OLIMEX/OLIMEXINO-2560/README.md

# OLIMEXINO-2560
Arduino Mega 2560 like board with ATMEGA2560 processor, 88 GPIOs, uSD card, 6-15VDC power

## License
* Software Licensee is GPL 3.0
* Hardware Licensee is CERN Open Hardware Licence v1.2
* Documentation is released under CC BY-SA 3.0
