OLIMEX/OLIMEXINO-2560/HARDWARE/OLIMEXINO-2560_Rev_A2_BOM.ods

Designation | Quantity | Designator | Package
SMD КЛЮЧ БУТОН TSW34-W16PR-220 / SIDE W | 1 | BUTTON1 | TSW34-W16PR-220
SMD КОНД 0402 100 NF 10% 10VDC | 7 | C1,C15,C17,C18,C19,C20,C21 | C_0402_5MIL_DWS
SMD КОНД 0402 10 NF X7R 50VDC | 1 | C10 | C_0603_5MIL_DWS
SMD КОНД 0402 12 PF NP0 5% | 2 | C11,C14 | C_0402_SMALL
SMD КОНД 0402 33 PF +-0.25 PF | 2 | C12,C13 | 402
SMD КОНД 0603 22 UF 6.3V | 6 | C2,C4,C5,C7,C8,C16 | C_0603_5MIL_DWS
SMD КОНД 1206 22 UF 25VDC X7R | 1 | C3 | C_1206_5MIL_DWS
(na)100nF | 1 | C6 | C_0402_5MIL_DWS
(na)2.2uF | 1 | C9 | C_0603_5MIL_DWS
SMBJ16A | 1 | D2 | SMB-KA
FB0805 | 3 | FB1,FB2,FB3 | L_0805_5MIL_DWS
IRML6402 | 2 | FET1,FET2 | SOT23
РЕЙКА 1 X 40 (HN 1X40) | 2 X 3/40 | J1, J2 | HN1x3
SMD ИНДУКТИВНОСТ CD43 4.7 UH | 1 | L1 | CD43
YELLOW | 1 | LED1 | LED_0603_KA_NOSILK
GREEN | 2 | LED2,LED4 | LED_0603_KA_NOSILK
RED | 2 | LED3,LED5 | LED_0603_KA_NOSILK
MICRO_SD(TFC-WXCP11-08-LF) | 1 | MICRO_SD1 | TFC-WXCP11-08-LF
СЪЕДИНИТЕЛ PWR-JACK (DC-004) | 1 | PWR1 | IDJ-1174.1
SMD РЕЗ. 5x3.2mm 16 Mhz 30PPM 12PF | 1 | Q1 | HCX-4S_2Pins_5.0x3.2mm
SMD РЕЗ 0402 330 OHM 5% | 1 | R15 | R_0402_5MIL_DWS
SMD РЕЗ 0402 1 K 5% | 3 | R16,R19,R21 | R_0402_5MIL_DWS
SMD РЕЗ 0402 2 K 5% | 5 | R1,R3,R6,R17,R18 | R_0402_5MIL_DWS
SMD РЕЗ 0603 49.9 K 1% | 1 | R4 | R_0603_5MIL_DWS
SMD РЕЗ 0402 10 K 5% | 10 | R2,R5,R8,R9,R10,R11,R12,R13,R14,R20 | R_0402_5MIL_DWS
SMD РЕЗ 0402 6.81 K 1% | 1 | R7 | R_0402_5MIL_DWS
SMD ИС SY8120B1 4.5-18V 2A | 1 | U1 | SOT23-6
SMD ИС CH340T SSOP20 | 1 | U2 | SSOP-20W
SMD ИС MCP1700T-3302E/MB | 1 | U3 | SOT89
SMD ИС ATMEGA2560-16AU | 1 | U4 | TQFP100
SMD ДИОД BAT54TW | 1 | U5 | SOT363
СЪЕДИНИТЕЛ BH10R 2x5 ЪГЪЛ | 1 | UEXT1 | UEXT_BH10R
SMD СЪЕДИНИТЕЛ MISB-SWMM-5B-LF /USB-MICRO/ | 1 | USB1 | USB-MICRO-5P-F
SMD РЕЗОНАТОР КВАРЦ - 12 MHZ 30ppm 20pf | 1 | X1 | Q_49U3HMS
СЪЕДИНИТЕЛ FE-D13A-1X06-LF(H=11.04mm) | 1
СЪЕДИНИТЕЛ FE-D13A-1X08-LF(H=11.04mm) | 3
Променени са стойностите на: R9,R10, R20, C11, C12
