OLIMEX/OLIMEXINO-2560/HARDWARE/3d/CD32_inductor.step

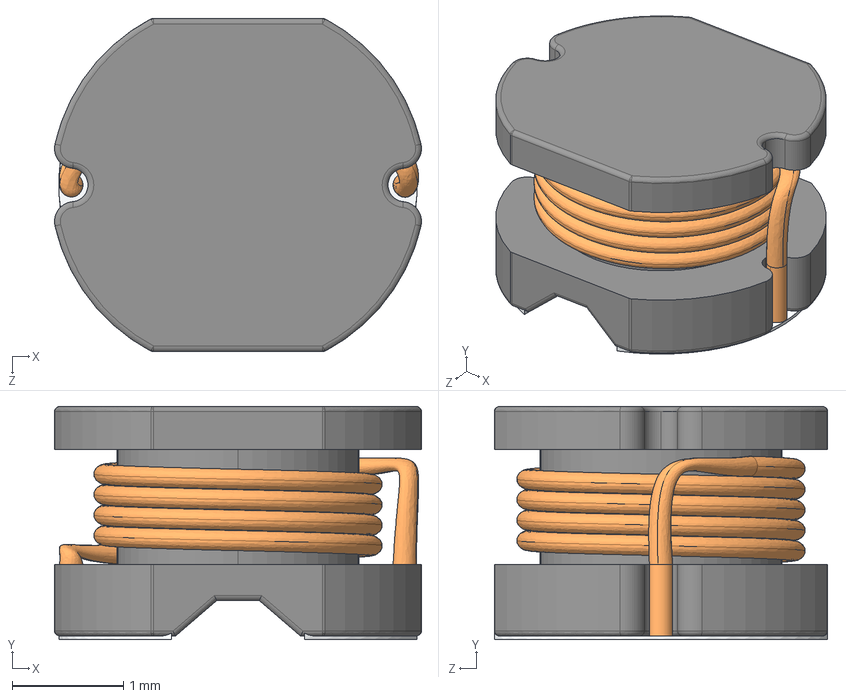
[picture p1: CAD file, 2019-06-20]
HARDWARE/3d/CD32_inductor.step
3.30 x 2.10 x 3.00 mm
