OLIMEX/OLIMEXINO-2560/HARDWARE/3d/usb_micro_4p.stp

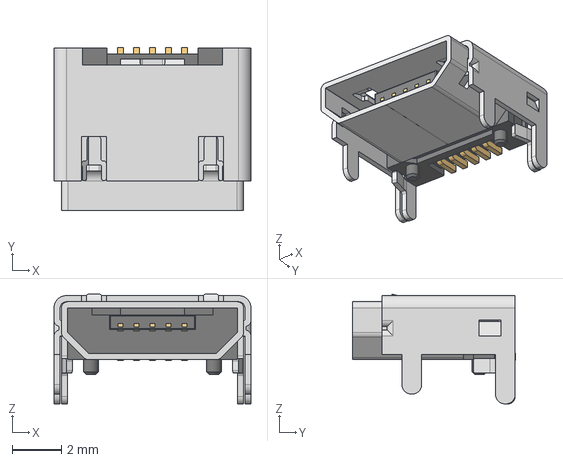
[picture p2: CAD file, 2019-06-20]
HARDWARE/3d/usb_micro_4p.stp
8.00 x 6.60 x 4.46 mm
