OLIMEX/OLIMEXINO-2560/HARDWARE/3d/SOT-23.step

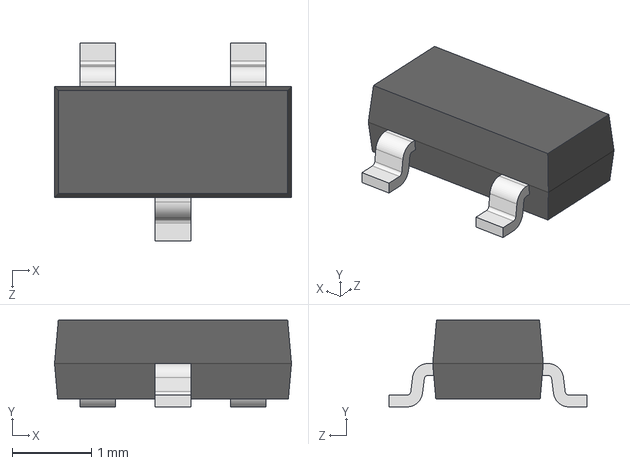
[picture p3: CAD file, 2019-06-20]
HARDWARE/3d/SOT-23.step
3.00 x 1.10 x 2.50 mm
