OLIMEX/OLIMEXINO-2560/HARDWARE/3d/Header_right_angle_10way(2x5).step

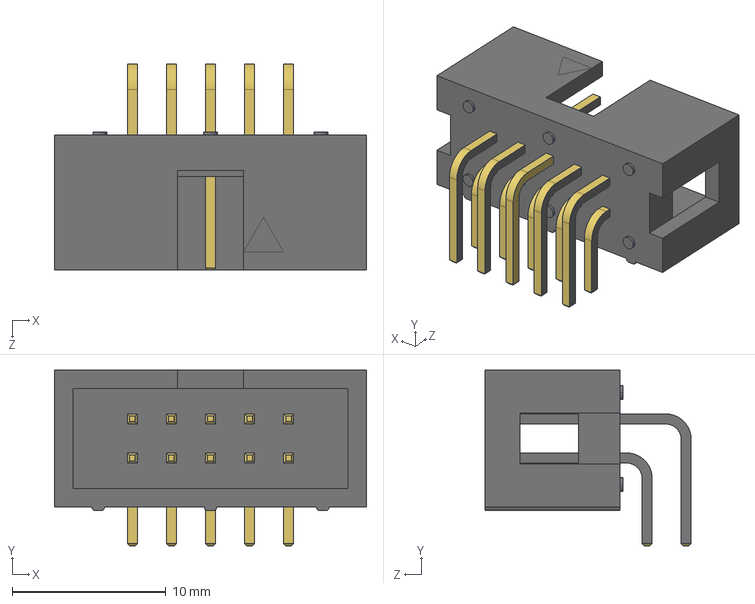
[picture p4: CAD file, 2019-06-20]
HARDWARE/3d/Header_right_angle_10way(2x5).step
20.3 x 11.4 x 13.4 mm
