OLIMEX/OLIMEXINO-2560/HARDWARE/3d/SOT-23-6.step

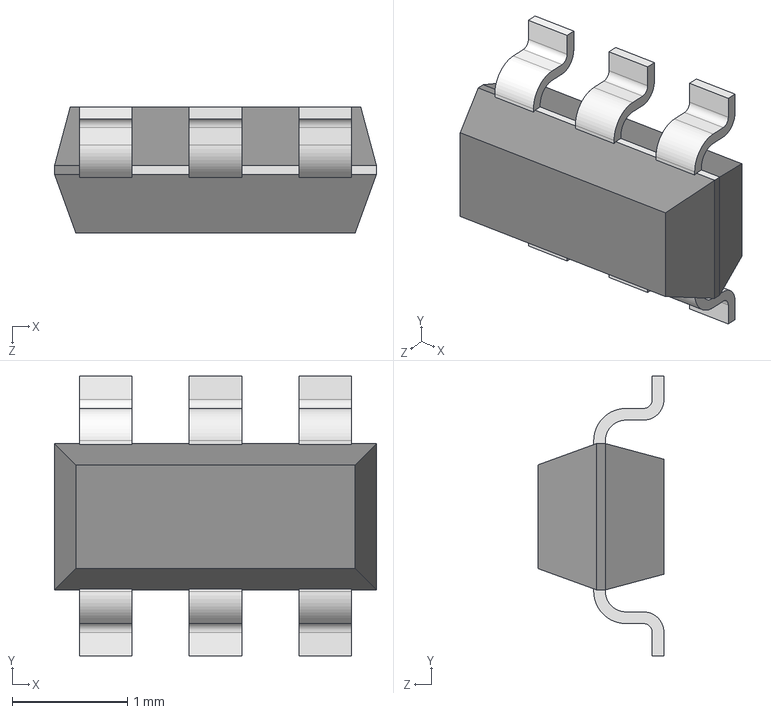
[picture p5: CAD file, 2019-06-20]
HARDWARE/3d/SOT-23-6.step
2.79 x 2.43 x 1.09 mm
