OLIMEX/OLIMEXINO-2560/HARDWARE/3d/Header _Fem_1X8.step

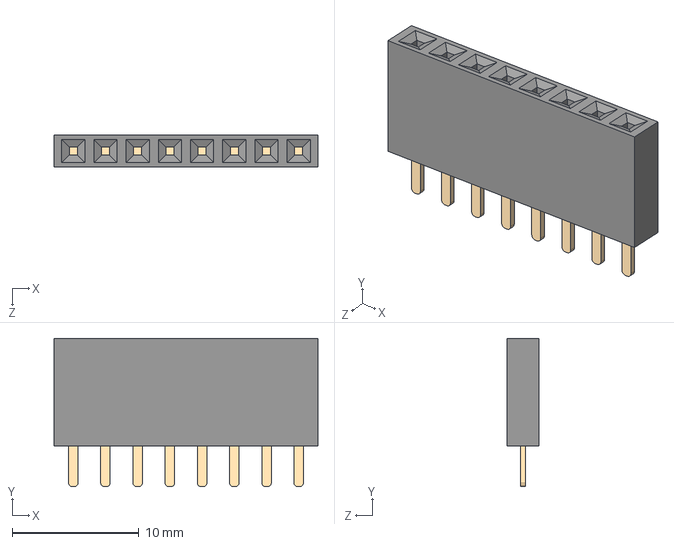
[picture p6: CAD file, 2019-06-20]
HARDWARE/3d/Header _Fem_1X8.step
20.8 x 11.7 x 2.54 mm
