OLIMEX/OLIMEXINO-2560/HARDWARE/3d/DO-214AA_SMB.step

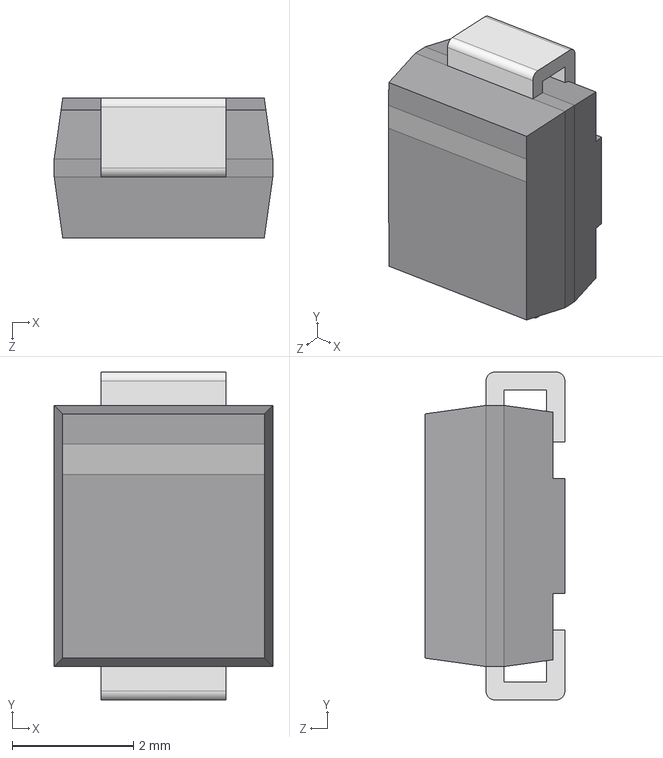
[picture p7: CAD file, 2019-06-20]
HARDWARE/3d/DO-214AA_SMB.step
3.60 x 5.40 x 2.30 mm
