OLIMEX/OLIMEXINO-2560/HARDWARE/3d/Header_Fem_1X6.step

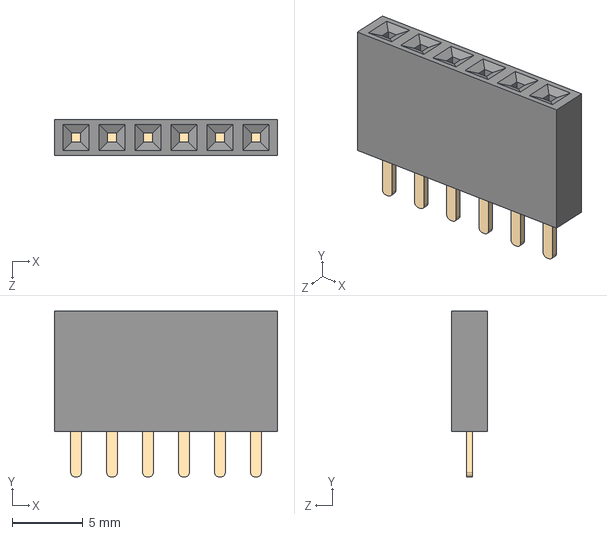
[picture p8: CAD file, 2019-06-20]
HARDWARE/3d/Header_Fem_1X6.step
15.7 x 11.7 x 2.54 mm
