OLIMEX/OLIMEXINO-2560/HARDWARE/3d/Header_Fem_1X4.step

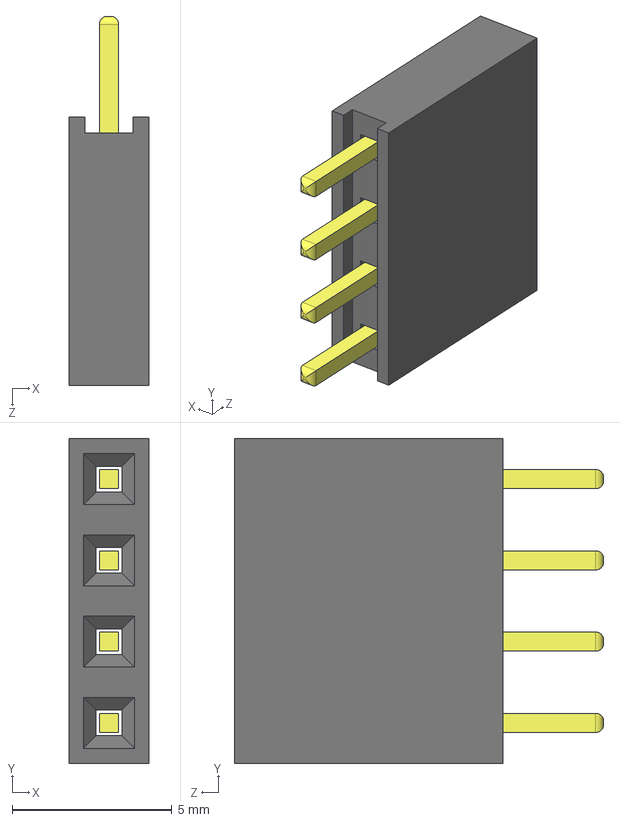
[picture p9: CAD file, 2019-06-20]
HARDWARE/3d/Header_Fem_1X4.step
2.50 x 10.2 x 11.6 mm
