OLIMEX/OLIMEXINO-2560/HARDWARE/3d/HN1x3.step

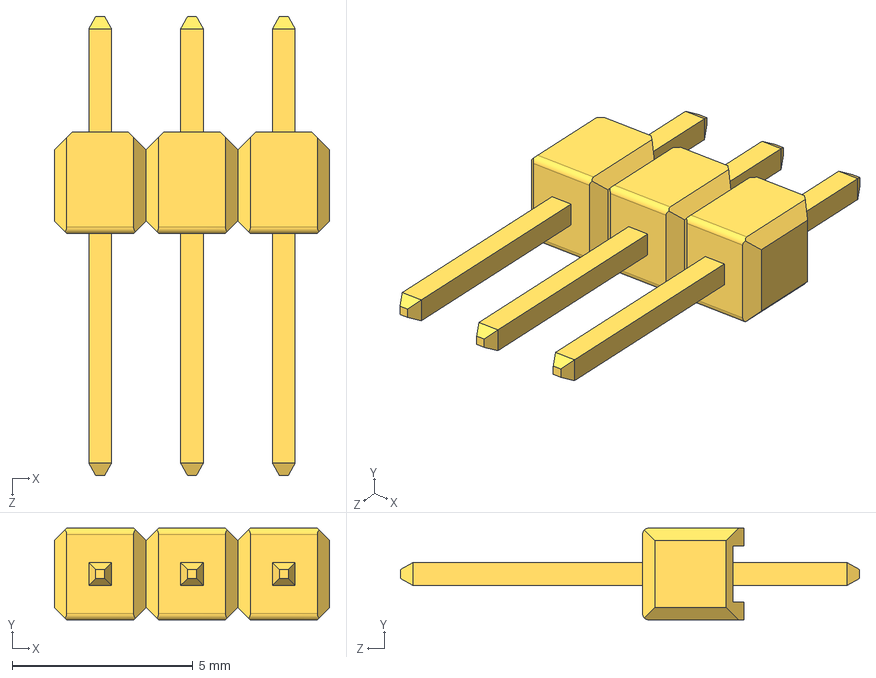
[picture p10: CAD file, 2019-06-20]
HARDWARE/3d/HN1x3.step
7.62 x 2.54 x 12.7 mm
