OLIMEX/OLIMEXINO-2560/HARDWARE/3d/tactile_sidesw.stp

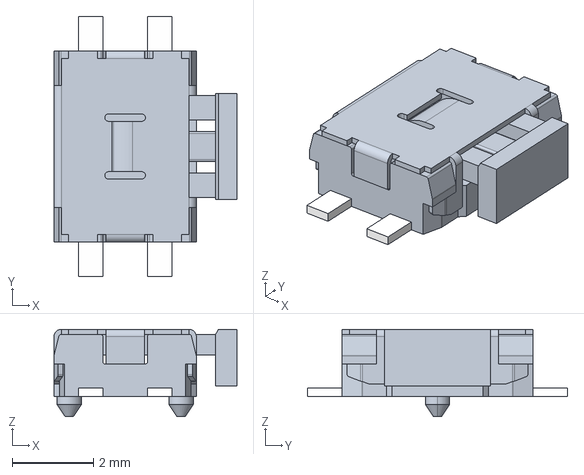
[picture p11: CAD file, 2019-06-20]
HARDWARE/3d/tactile_sidesw.stp
4.50 x 6.40 x 2.15 mm
