OLIMEX/OLIMEXINO-2560/HARDWARE/3d/User_Library-Crystal_HC49_US-SM.step

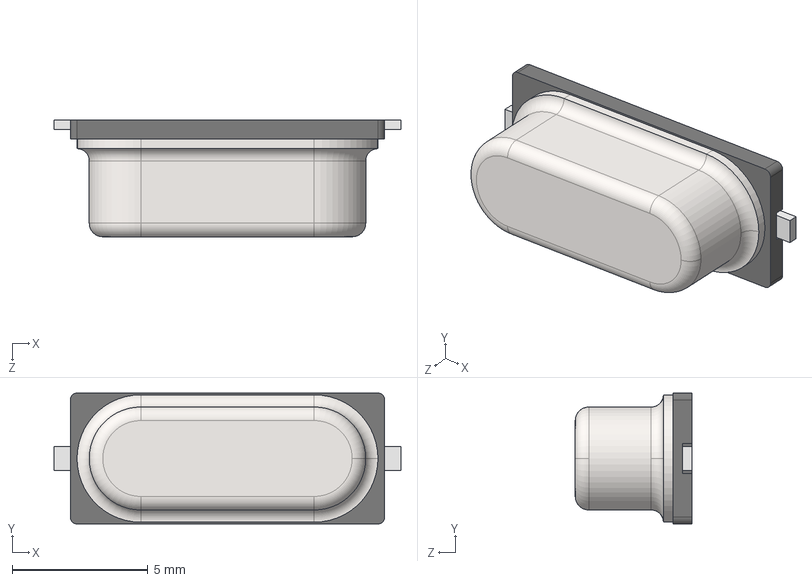
[picture p12: CAD file, 2019-06-20]
HARDWARE/3d/User_Library-Crystal_HC49_US-SM.step
12.8 x 4.83 x 4.30 mm
