OLIMEX/OLIMEXINO-2560/HARDWARE/3d/JUMPER.step

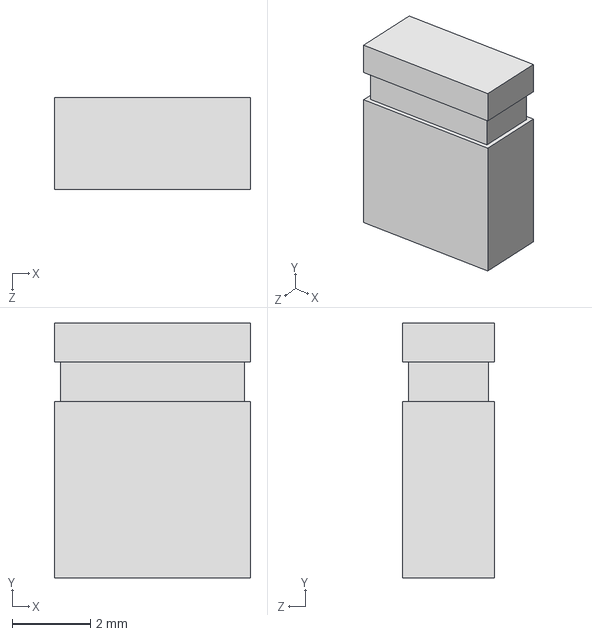
[picture p13: CAD file, 2019-06-20]
HARDWARE/3d/JUMPER.step
5.00 x 6.50 x 2.35 mm
