OLIMEX/OLIMEXINO-2560/HARDWARE/3d/SOT-89.step

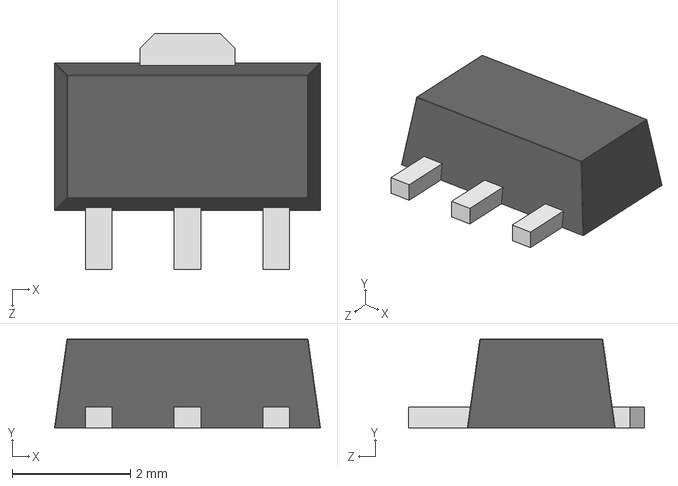
[picture p14: CAD file, 2019-06-20]
HARDWARE/3d/SOT-89.step
4.50 x 1.50 x 4.00 mm
