OLIMEX/OLIMEXINO-2560/HARDWARE/3d/pj-003a.stp

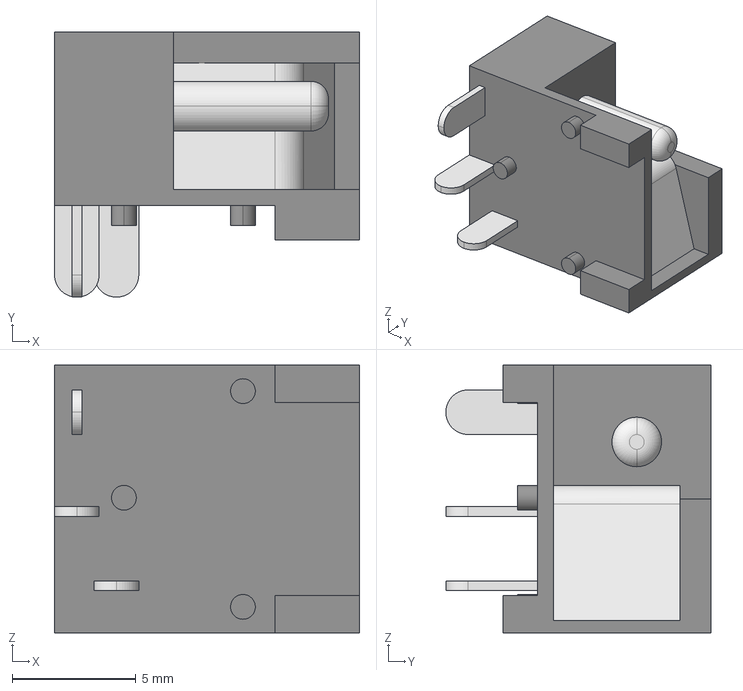
[picture p15: CAD file, 2019-06-20]
HARDWARE/3d/pj-003a.stp
12.3 x 10.7 x 10.8 mm
