OLIMEX/OLIMEXINO-2560/HARDWARE/3d/SMD5032.STEP

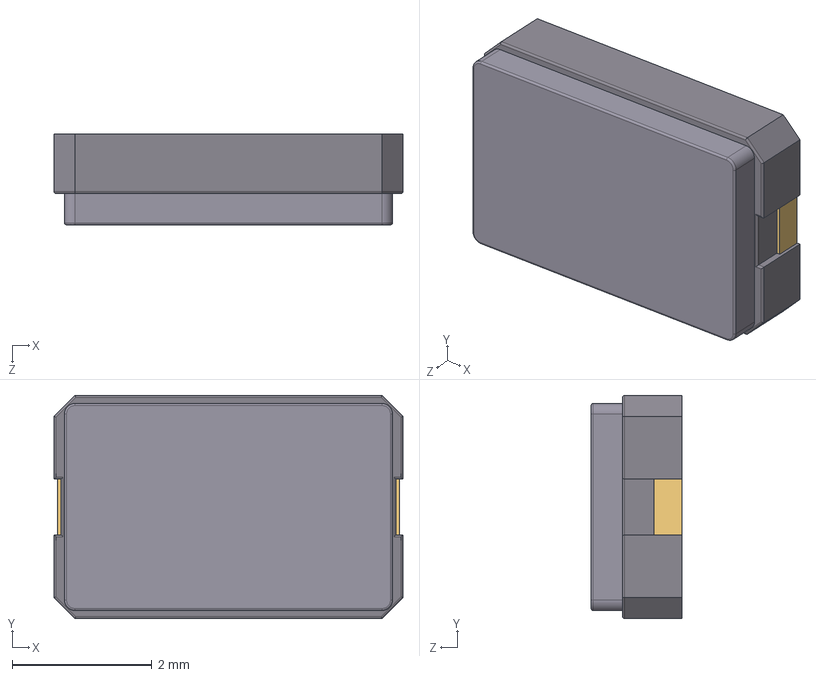
[picture p16: CAD file, 2019-06-20]
HARDWARE/3d/SMD5032.STEP
5.00 x 3.20 x 1.30 mm
User Library-ABM3-1_Fillet002
User Library-ABM3-1_Fillet001
User Library-ABM3-1_Pad001
