OLIMEX/OLIMEXINO-2560/HARDWARE/3d/693063020911.stp

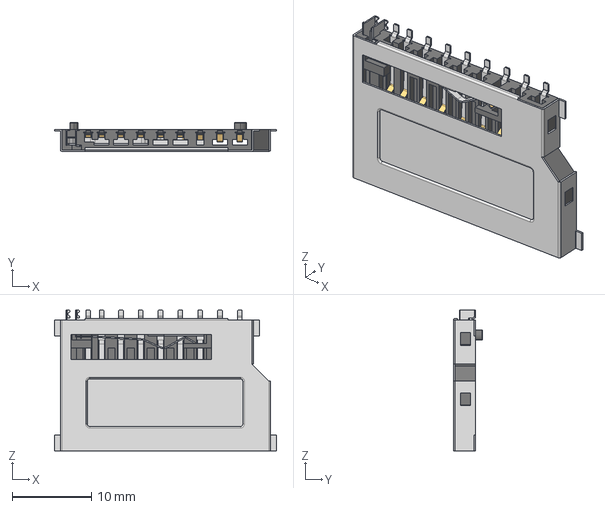
[picture p17: CAD file, 2019-06-20]
HARDWARE/3d/693063020911.stp
28.0 x 3.65 x 17.8 mm
