OLIMEX/OLIMEXINO-2560/HARDWARE/OLIMEXINO-2560_Rev_B.pdf

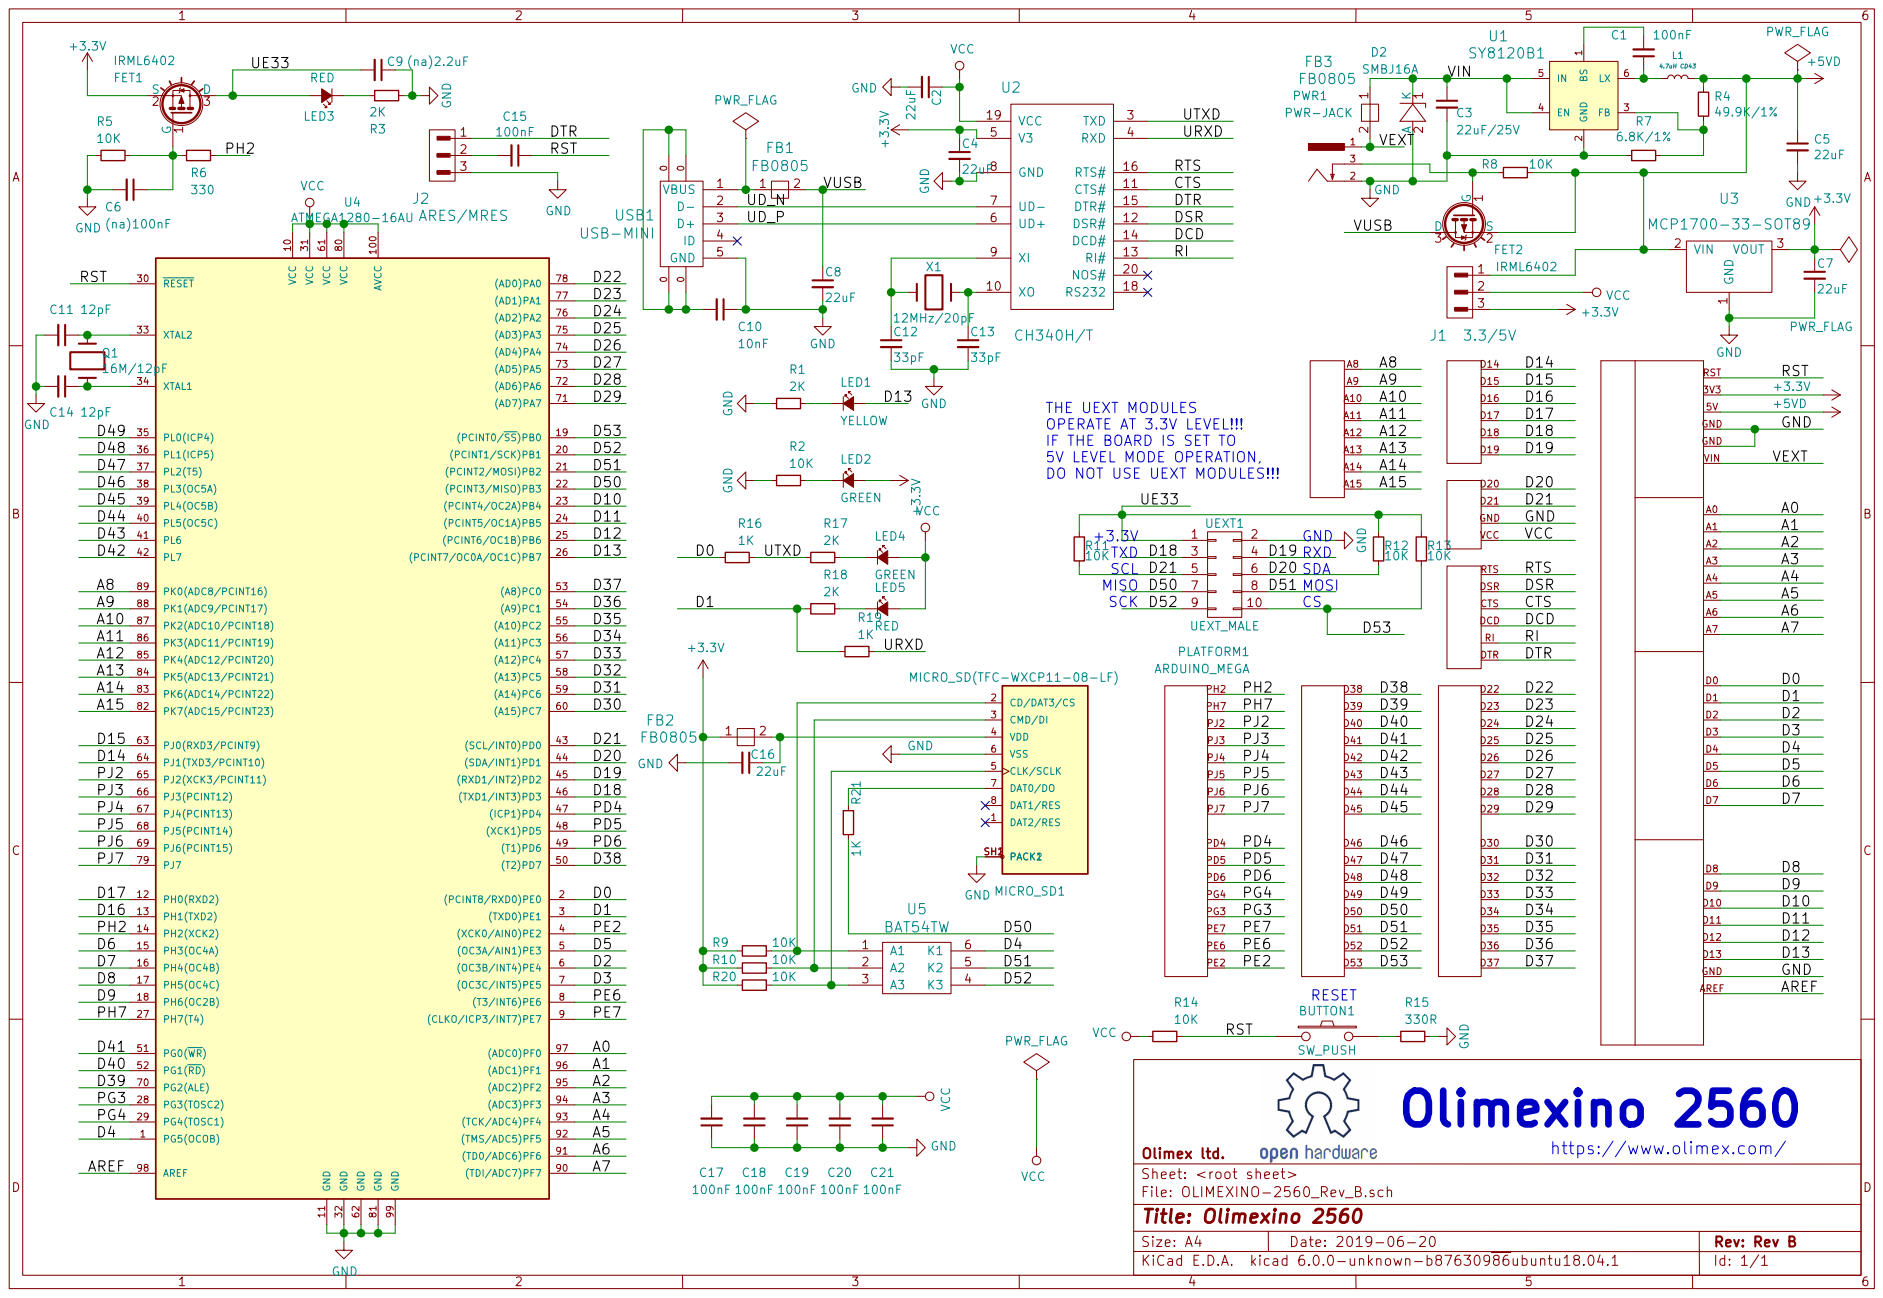
[picture p20: page 1]

OPERATE AT 3.3V LEVEL!!!
IF THE BOARD IS SET TO
5V LEVEL MODE OPERATION,

DO NOT USE UEXT MODULES!!! C17

File: OLIMEXINO-2560_Rev_B.sch Sheet: <root sheet> Olimex ltd.

https://www.olimex.com/
