OLIMEX/OLIMEXINO-2560/HARDWARE/OLIMEXINO-2560_Rev_B.kicad_pcb

## KiCad design HARDWARE/OLIMEXINO-2560_Rev_B.kicad_pcb (2019-06-20)

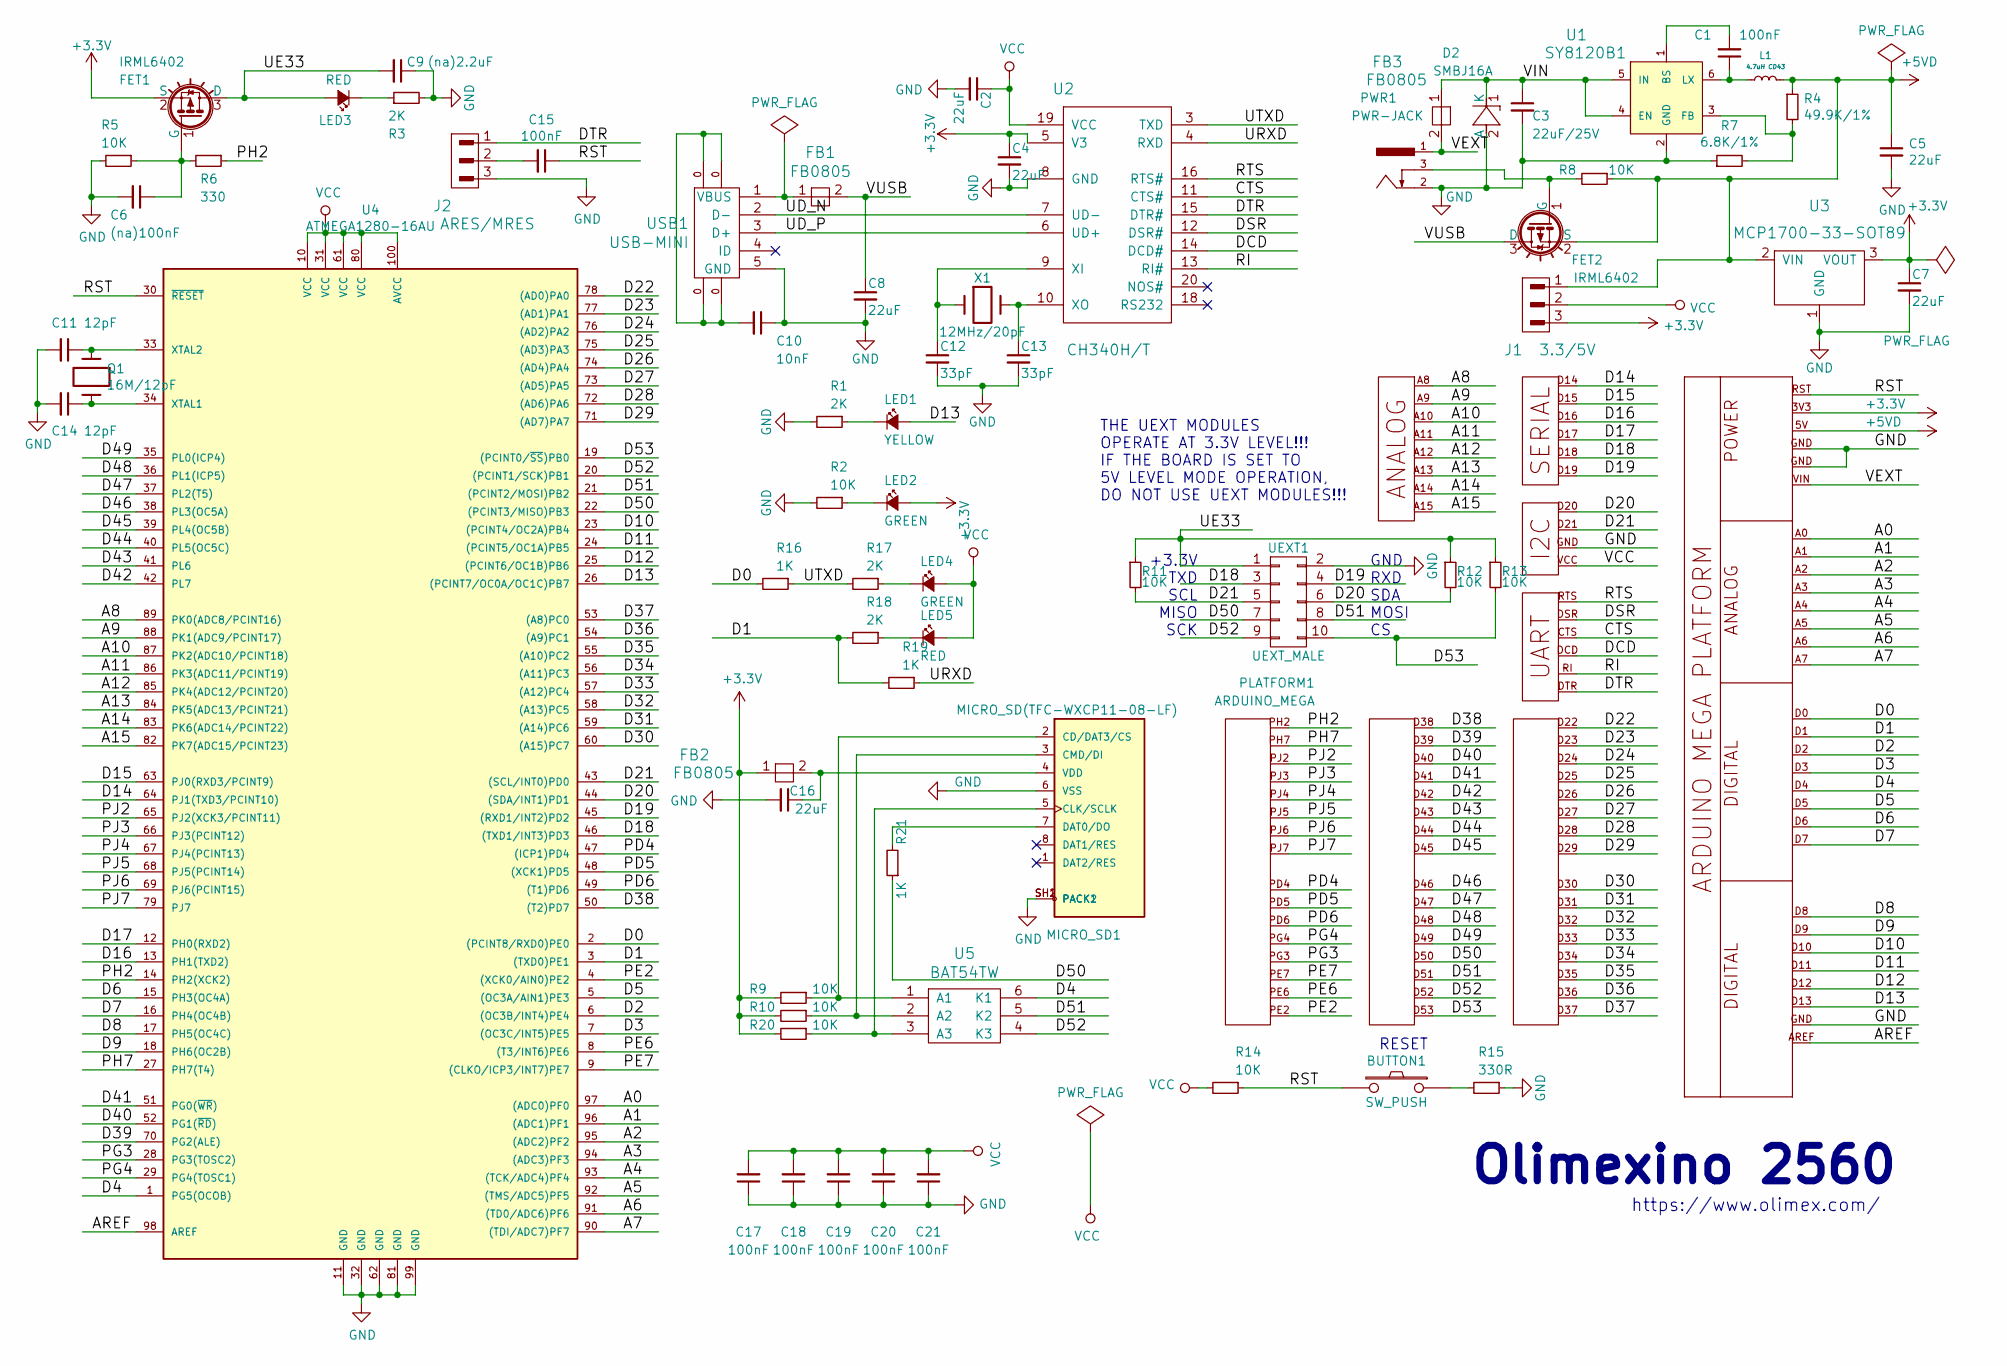
[picture p21: schematic OLIMEXINO-2560_Rev_B.sch, Olimexino 2560]

Parts:
BUTTON1: SW_PUSH; TSW34-W16PR-220
C1, C15, C17, C18, C19, C20, C21: 100nF; C_0402_5MIL_DWS
C2, C4, C5, C7, C8, C16: 22uF; C_0603_5MIL_DWS
C3: 22uF/25V; C_1206_5MIL_DWS
C6: (na)100nF; C_0402_5MIL_DWS
C9: (na)2.2uF; C_0603_5MIL_DWS
C10: 10nF; C_0603_5MIL_DWS
C11, C14: 12pF; C_0402_SMALL
C12, C13: 33pF; 0402
D2: SMBJ16A; SMB-KA
FB1, FB2, FB3: FB0805; L_0805_5MIL_DWS
FET1, FET2: IRML6402; SOT23
J1: 3.3/5V; HN1x3
J2: ARES/MRES; HN1x3
L1: 4.7uH CD43; CD43
LED1: YELLOW; LED_0603_KA_NOSILK
LED2, LED4: GREEN; LED_0603_KA_NOSILK
LED3, LED5: RED; LED_0603_KA_NOSILK
MICRO_SD1: MICRO_SD(TFC-WXCP11-08-LF); TFC-WXCP11-08-LF
PLATFORM1: ARDUINO_MEGA; OLIMEX_CASES-ARDUINO-MEGA-PLATFORM
PWR1: PWR-JACK; PWRJACK-FLAT
Q1: 16M/12pF; HCX-4S_2Pins_5.0x3.2mm
R1, R3, R17, R18: 2K; R_0402_5MIL_DWS
R2, R5, R8, R9, R10, R11, R12, R13, R14, R20: 10K; R_0402_5MIL_DWS
R4: 49.9K/1%; R_0603_5MIL_DWS
R6: 330; R_0402_5MIL_DWS
R7: 6.8K/1%; R_0402_5MIL_DWS
R15: 330R; R_0402_5MIL_DWS
R16, R19, R21: 1K; R_0402_5MIL_DWS
U1: SY8120B1; SOT23-6
U2: CH340H/T; SSOP-20W
U3: MCP1700-33-SOT89; SOT89
U4: ATMEGA1280-16AU; TQFP100
U5: BAT54TW; SOT363
UEXT1: UEXT_MALE; UEXT_BH10R
USB1: USB-MINI; MICRO_USB_5P-F_TYPE_DIP
X1: 12MHz/20pF; Q_49U3HMS

Connections:
+3V3: C4.1, C7.1, FB2.1, FET1.2 (S), J1.3, LED2.2 (A), PLATFORM1.3V3, R9.2, R10.2, R20.2, U2.5 (V3), U3.3 (VOUT)
+5VD: C5.1, FET2.2 (S), J1.1, L1.2, PLATFORM1.5V, R4.1, R8.1, U3.2 (VIN)
/A0: PLATFORM1.A0, U4.97 ((ADC0)PF0)
/A1: PLATFORM1.A1, U4.96 ((ADC1)PF1)
/A2: PLATFORM1.A2, U4.95 ((ADC2)PF2)
/A3: PLATFORM1.A3, U4.94 ((ADC3)PF3)
/A4: PLATFORM1.A4, U4.93 ((TCK/ADC4)PF4)
/A5: PLATFORM1.A5, U4.92 ((TMS/ADC5)PF5)
/A6: PLATFORM1.A6, U4.91 ((TD0/ADC6)PF6)
/A7: PLATFORM1.A7, U4.90 ((TDI/ADC7)PF7)
/A8: PLATFORM1.A8, U4.89 (PK0(ADC8/PCINT16))
/A9: PLATFORM1.A9, U4.88 (PK1(ADC9/PCINT17))
/A10: PLATFORM1.A10, U4.87 (PK2(ADC10/PCINT18))
/A11: PLATFORM1.A11, U4.86 (PK3(ADC11/PCINT19))
/A12: PLATFORM1.A12, U4.85 (PK4(ADC12/PCINT20))
/A13: PLATFORM1.A13, U4.84 (PK5(ADC13/PCINT21))
/A14: PLATFORM1.A14, U4.83 (PK6(ADC14/PCINT22))
/A15: PLATFORM1.A15, U4.82 (PK7(ADC15/PCINT23))
/AREF: PLATFORM1.AREF, U4.98 (AREF)
/CTS: PLATFORM1.CTS, U2.11 (CTS#)
/D0: PLATFORM1.D0, R16.2, U4.2 ((PCINT8/RXD0)PE0)
/D1: PLATFORM1.D1, R18.2, R19.2, U4.3 ((TXD0)PE1)
/D2: PLATFORM1.D2, U4.6 ((OC3B/INT4)PE4)
/D3: PLATFORM1.D3, U4.7 ((OC3C/INT5)PE5)
/D4: PLATFORM1.D4, U4.1 (PG5(OCOB)), U5.6 (K1)
/D5: PLATFORM1.D5, U4.5 ((OC3A/AIN1)PE3)
/D6: PLATFORM1.D6, U4.15 (PH3(OC4A))
/D7: PLATFORM1.D7, U4.16 (PH4(OC4B))
/D8: PLATFORM1.D8, U4.17 (PH5(OC4C))
/D9: PLATFORM1.D9, U4.18 (PH6(OC2B))
/D10: PLATFORM1.D10, U4.23 ((PCINT4/OC2A)PB4)
/D11: PLATFORM1.D11, U4.24 ((PCINT5/OC1A)PB5)
/D12: PLATFORM1.D12, U4.25 ((PCINT6/OC1B)PB6)
/D13: LED1.2 (A), PLATFORM1.D13, U4.26 ((PCINT7/OC0A/OC1C)PB7)
/D14: PLATFORM1.D14, U4.64 (PJ1(TXD3/PCINT10))
/D15: PLATFORM1.D15, U4.63 (PJ0(RXD3/PCINT9))
/D16: PLATFORM1.D16, U4.13 (PH1(TXD2))
/D17: PLATFORM1.D17, U4.12 (PH0(RXD2))
/D18: PLATFORM1.D18, U4.46 ((TXD1/INT3)PD3), UEXT1.3
/D19: PLATFORM1.D19, U4.45 ((RXD1/INT2)PD2), UEXT1.4
/D20: PLATFORM1.D20, R12.2, U4.44 ((SDA/INT1)PD1), UEXT1.6
/D21: PLATFORM1.D21, R11.2, U4.43 ((SCL/INT0)PD0), UEXT1.5
/D22: PLATFORM1.D22, U4.78 ((AD0)PA0)
/D23: PLATFORM1.D23, U4.77 ((AD1)PA1)
/D24: PLATFORM1.D24, U4.76 ((AD2)PA2)
/D25: PLATFORM1.D25, U4.75 ((AD3)PA3)
/D26: PLATFORM1.D26, U4.74 ((AD4)PA4)
/D27: PLATFORM1.D27, U4.73 ((AD5)PA5)
/D28: PLATFORM1.D28, U4.72 ((AD6)PA6)
/D29: PLATFORM1.D29, U4.71 ((AD7)PA7)
/D30: PLATFORM1.D30, U4.60 ((A15)PC7)
/D31: PLATFORM1.D31, U4.59 ((A14)PC6)
/D32: PLATFORM1.D32, U4.58 ((A13)PC5)
/D33: PLATFORM1.D33, U4.57 ((A12)PC4)
/D34: PLATFORM1.D34, U4.56 ((A11)PC3)
/D35: PLATFORM1.D35, U4.55 ((A10)PC2)
/D36: PLATFORM1.D36, U4.54 ((A9)PC1)
/D37: PLATFORM1.D37, U4.53 ((A8)PC0)
/D38: PLATFORM1.D38, U4.50 ((T2)PD7)
/D39: PLATFORM1.D39, U4.70 (PG2(ALE))
/D40: PLATFORM1.D40, U4.52 (PG1(~RD~))
/D41: PLATFORM1.D41, U4.51 (PG0(~WR~))
/D42: PLATFORM1.D42, U4.42 (PL7)
/D43: PLATFORM1.D43, U4.41 (PL6)
/D44: PLATFORM1.D44, U4.40 (PL5(OC5C))
/D45: PLATFORM1.D45, U4.39 (PL4(OC5B))
/D46: PLATFORM1.D46, U4.38 (PL3(OC5A))
/D47: PLATFORM1.D47, U4.37 (PL2(T5))
/D48: PLATFORM1.D48, U4.36 (PL1(ICP5))
/D49: PLATFORM1.D49, U4.35 (PL0(ICP4))
/D50: PLATFORM1.D50, R21.1, U4.22 ((PCINT3/MISO)PB3), UEXT1.7
/D51: PLATFORM1.D51, U4.21 ((PCINT2/MOSI)PB2), U5.5 (K2), UEXT1.8
/D52: PLATFORM1.D52, U4.20 ((PCINT1/SCK)PB1), U5.4 (K3), UEXT1.9
/D53: PLATFORM1.D53, R13.2, U4.19 ((PCINT0/~SS~)PB0), UEXT1.10
/DCD: PLATFORM1.DCD, U2.14 (DCD#)
/DSR: PLATFORM1.DSR, U2.12 (DSR#)
/DTR: J2.1, PLATFORM1.DTR, U2.15 (DTR#)
/PD4: PLATFORM1.PD4, U4.47 ((ICP1)PD4)
/PD5: PLATFORM1.PD5, U4.48 ((XCK1)PD5)
/PD6: PLATFORM1.PD6, U4.49 ((T1)PD6)
/PE2: PLATFORM1.PE2, U4.4 ((XCK0/AIN0)PE2)
/PE6: PLATFORM1.PE6, U4.8 ((T3/INT6)PE6)
/PE7: PLATFORM1.PE7, U4.9 ((CLKO/ICP3/INT7)PE7)
/PG3: PLATFORM1.PG3, U4.28 (PG3(TOSC2))
/PG4: PLATFORM1.PG4, U4.29 (PG4(TOSC1))
/PH2: PLATFORM1.PH2, R6.1, U4.14 (PH2(XCK2))
/PH7: PLATFORM1.PH7, U4.27 (PH7(T4))
/PJ2: PLATFORM1.PJ2, U4.65 (PJ2(XCK3/PCINT11))
/PJ3: PLATFORM1.PJ3, U4.66 (PJ3(PCINT12))
/PJ4: PLATFORM1.PJ4, U4.67 (PJ4(PCINT13))
/PJ5: PLATFORM1.PJ5, U4.68 (PJ5(PCINT14))
/PJ6: PLATFORM1.PJ6, U4.69 (PJ6(PCINT15))
/PJ7: PLATFORM1.PJ7, U4.79 (PJ7)
/RI: PLATFORM1.RI, U2.13 (RI#)
/RST: BUTTON1.2, C15.1, PLATFORM1.RST, R14.1, U4.30 (~RESET)
/RTS: PLATFORM1.RTS, U2.16 (RTS#)
/UD_N: U2.7 (UD-), USB1.2 (D-)
/UD_P: U2.6 (UD+), USB1.3 (D+)
/UE33: C9.2, FET1.3 (D), LED3.2 (A), R11.1, R12.1, R13.1, UEXT1.1
/URXD: R19.1, U2.4 (RXD)
/UTXD: R16.1, R17.2, U2.3 (TXD)
/VEXT: FB3.2, PLATFORM1.VIN, PWR1.1 (+)
/VIN: C3.1, D2.1 (K), FB3.1, U1.4 (EN), U1.5 (IN)
/VUSB: C8.1, FB1.2, FET2.3 (D)
GND: C2.2, C3.2, C4.2, C5.2, C6.2, C7.2, C8.2, C9.1, C10.1, C11.2, C12.2, C13.2, C14.2, C16.2, C17.1, C18.1, C19.1, C20.1, C21.1, D2.2 (A), J2.3, MICRO_SD1.6 (VSS), MICRO_SD1.SH1 (PACK1), MICRO_SD1.SH2 (PACK2), PLATFORM1.GND, PWR1.2 (-), R1.2, R2.2, R3.2, R5.2, R7.1, R15.1, U1.2 (GND), U2.8 (GND), U3.1 (GND), U4.11 (GND), U4.32 (GND), U4.62 (GND), U4.81 (GND), U4.99 (GND), UEXT1.2, USB1.5 (GND)
unnamed: BUTTON1.1, R15.2
unnamed: C1.1, L1.1, U1.6 (LX)
unnamed: C1.2, U1.1 (BS)
unnamed: C6.1, FET1.1 (G), R5.1, R6.2
unnamed: C10.2, USB1.0
unnamed: C11.1, Q1.1, U4.33 (XTAL2)
unnamed: C12.1, U2.9 (XI), X1.1
unnamed: C13.1, U2.10 (XO), X1.2
unnamed: C14.1, Q1.2, U4.34 (XTAL1)
unnamed: C15.2, J2.2
unnamed: C16.1, FB2.2, MICRO_SD1.4 (VDD)
unnamed: FB1.1, USB1.1 (VBUS)
unnamed: FET2.1 (G), PWR1.3 (-), R8.2
unnamed: LED1.1 (K), R1.1
unnamed: LED2.1 (K), R2.1
unnamed: LED3.1 (K), R3.1
unnamed: LED4.1 (K), R17.1
unnamed: LED5.1 (K), R18.1
unnamed: MICRO_SD1.2 (CD/DAT3/CS), R9.1, U5.1 (A1)
unnamed: MICRO_SD1.3 (CMD/DI), R10.1, U5.2 (A2)
unnamed: MICRO_SD1.5 (CLK/SCLK), R20.1, U5.3 (A3)
unnamed: MICRO_SD1.7 (DAT0/DO), R21.2
unnamed: R4.2, R7.2, U1.3 (FB)
VCC: C2.1, C17.2, C18.2, C19.2, C20.2, C21.2, J1.2, LED4.2 (A), LED5.2 (A), PLATFORM1.VCC, R14.2, U2.19 (VCC), U4.10 (VCC), U4.31 (VCC), U4.61 (VCC), U4.80 (VCC), U4.100 (AVCC)

Notes on the sheet:
RESET
+3.3V TXD SCL MISO SCK
GND RXD SDA MOSI CS
THE UEXT MODULES OPERATE AT 3.3V LEVEL!!! IF THE BOARD IS SET TO 5V LEVEL MODE OPERATION, DO NOT USE UEXT MODULES!!!
Olimexino 2560
https://www.olimex.com/

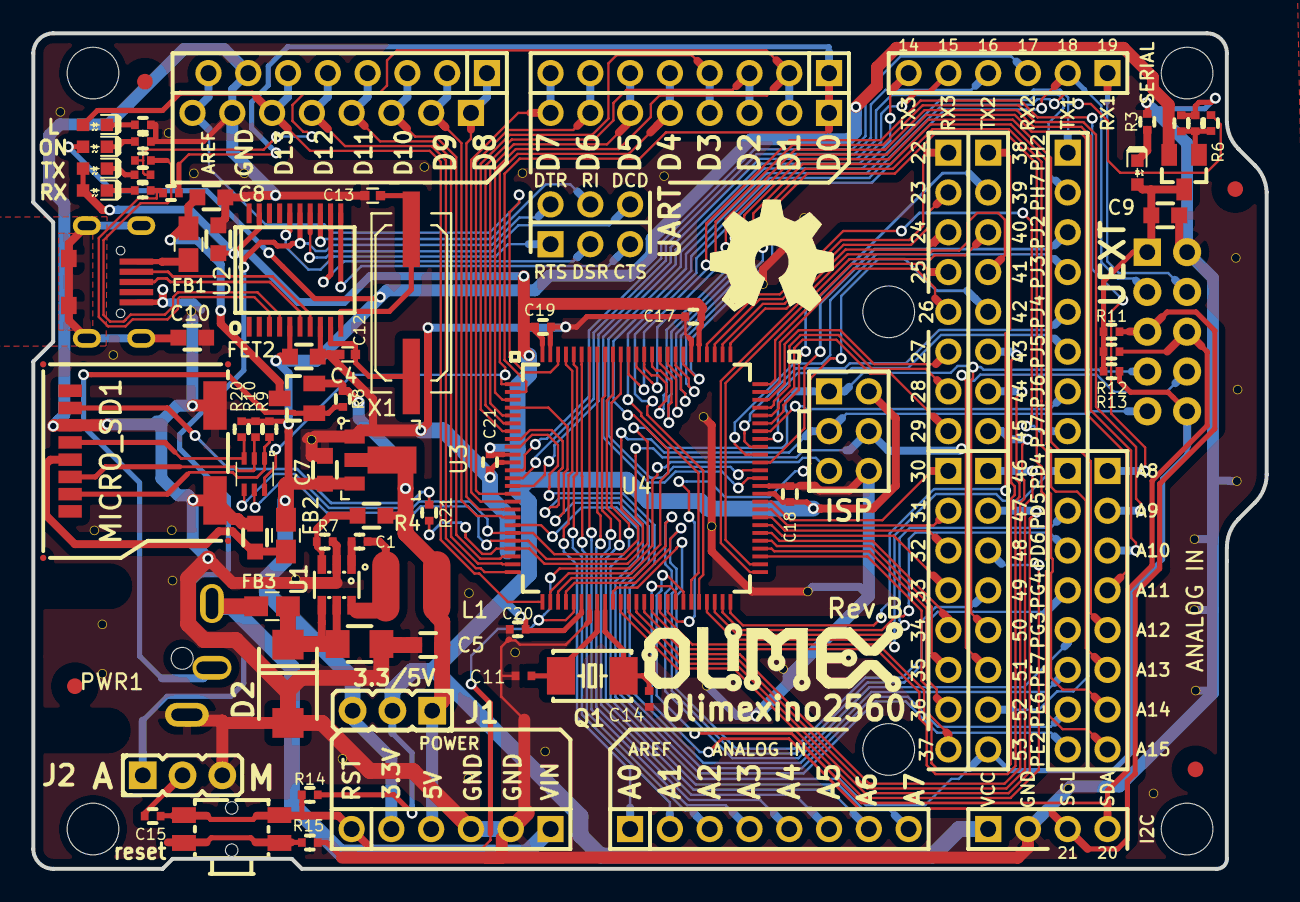
[picture p22: board OLIMEXINO-2560_Rev_B.kicad_pcb from above]

Board: 2 copper layers, 78.7 x 53.3 mm, 73 parts (0 on the bottom side), 129 nets.

Other parts of the board:
Ref**: Val**; Fiducial1x3_transp
Ref**#2, Ref**#3, Ref**#4: Val**; Fiducial1x3_transp
